daviddobbie/rocketProject2017/Active-Stabilisation-Gyroscope/Gimbal MK4/README.md

# Active Stabilisation Gyroscope Gimbal MK4
This is the fourth iteration of the rocket motor gimbal

[Onshape Document](https://cad.onshape.com/documents/ac475682b0dcfe2c53e7e1ff/v/39afad7ddf3185f5003d1adf/e/2e63972efa3253e1ef49b592)

This design was made to have similar operation to the previous gimbal revisions using the dual ring gyroscopic system. This gimbal design provided the ability to operate rockets using up to a G class rocket motor. This therefore meaning that larger rockets could be launched with this design. This design was made to be integrated into the 1st stage (Booster stage) of the projects 2 stage active to passive rocket system

### Hardware Required

    * HC2422T Servo
    * 1/32inch control rod
    * 4X M3x10mm
    * 2X M3x15mm
    * 4X M3x20mm
    * 2X M3x35mm
