daviddobbie/rocketProject2017/Tech Docs/costchart.md

|Item|Unit Cost (NZD)|QTY|Total Cost (NZD)|
|----|---|---|---|
|Teensy 3.6 Dev Board|57.44|2|114.88|
|RFM96W Radio| 30.56|2|61.12|
|SMA End Launcher Connector|4.46|2|8.92|
|[SiRFstarIV GPS module](http://nz.element14.com/maestro-wireless-solutions/a2200a/gps-module-rom-based-mini-outline/dp/228169401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)|20.20|1|20.20|
|[MPA-154-ANT L1 GPS](http://nz.element14.com/maxtena/mpa-154/ant-l1-gps-passive-embedded-15mm/dp/2281625#anchorTechnicalDOCS)|9.93|3|29.79|
|[RF switch](http://nz.element14.com/skyworks-solutions/as214-92lf/ic-switch-rf-spdt-0-01-3-0ghz/dp/1753767)|2.01|3|2.01|
|[Metal Gear High Voltage Digital Servo ](https://hobbyking.com/en_us/jx-pdi-hv2546mg-metal-gear-high-voltage-digital-park-servo-6-6kg-0-10sec-26-32g.html)|20.16|2|40.32|
|[TG9e Eco Micro Servo 1.5kg](https://hobbyking.com/en_us/turnigytm-tg9e-eco-micro-servo-1-5kg-0-10sec-9g.html?wrh_pdp=3)|2.34|2|4.68|
|[100pF 1206 Capacitor](http://nz.element14.com/walsin/1206n101j500ct/capacitor-mlcc-np0-100pf-50v-1206/dp/2497125)|0.028|10|0.28|
|[10kohm 1206 Resistor](http://nz.element14.com/walsin/wr12x1002ftl/res-thick-film-10k-1-200v-1206/dp/2502605)|0.005|10|0.05|
|[GY-91 IMU breakout](https://www.banggood.com/GY-91-MPU9250-BMP280-10DOF-Acceleration-Gyroscope-Compass-Nine-Shaft-Sensor-Module-p-1129541.html)|11.75|1|11.75|
|SBR3U40P1-7 SMT Schottky Diode|0.715|10|7.15|
|PCB|20.00(est.)|1|20.00|
|Total Cost|||321.15|
