daviddobbie/rocketProject2017/Imu-Demonstration/IMU.pptx

## IMU Development

//TODO: Plan, Actual, Future

## What is an IMU?

- An IMU, also known as an Inertial Measurement Unit, is an electronic component that measures intrinsic properties related to orientation.
- Generates rates of change w.r.t. acceleration, gyroscopic, & magnetic data in the (x,y,z) axes.
- Quaternion mathematics can be applied to produce

## Why do we need an IMU?

## How the IMU integrates into the rocket avionics package

## IMU procurement & selection

- Procurement was performed by

## IMU Software Development Pt. 1

## IMU Software development Pt. 2

## How the IMU software meets performance quality metrics

## How the IMU software meets correctness quality metrics

## Demonstration

- Running on an Arduino board
