daviddobbie/rocketProject2017/Rocket Modelling/readme.md

# Rocket Modelling
## Open Rocket
All the rocket designs were modelled with the OpenRocket software.    
This was done to simulate each designs performance when launched.   
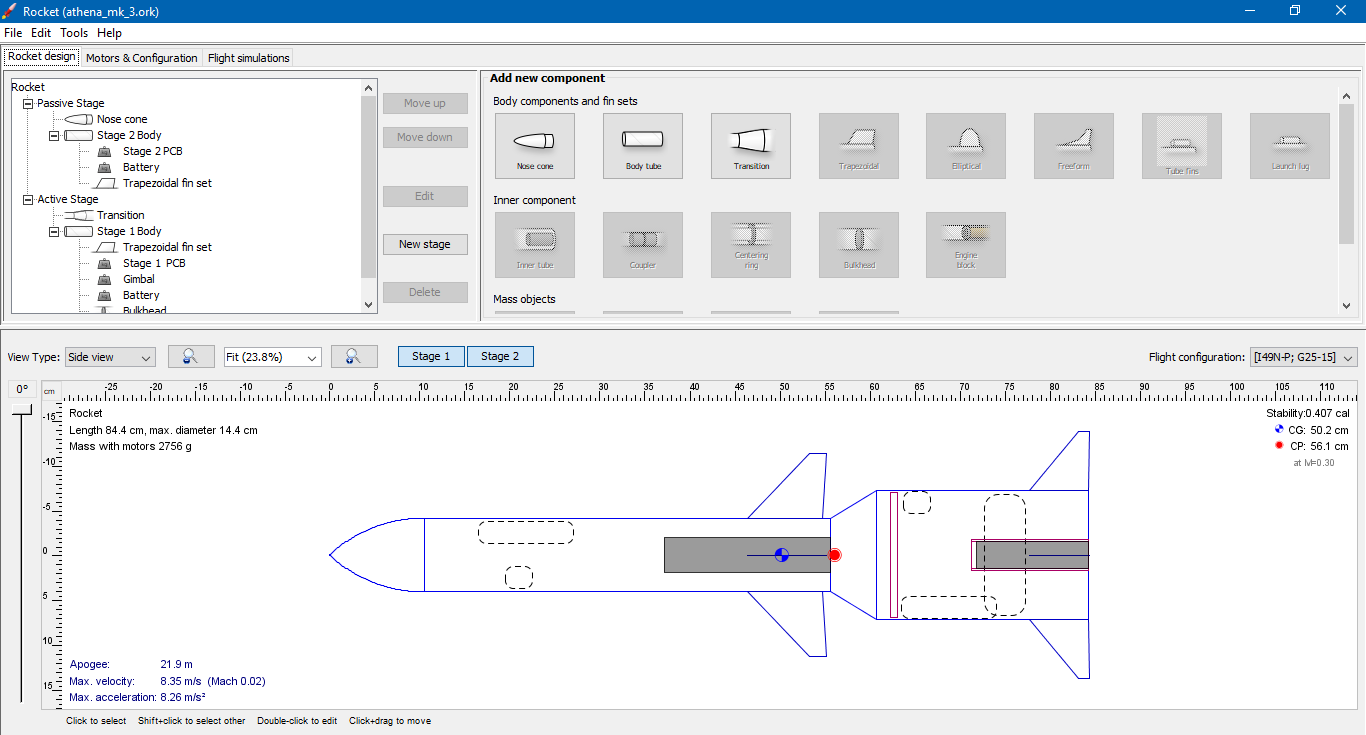
[picture p6: Rocket Modelling/openrocket_demo.PNG]
OpenRocket Interface
