daviddobbie/rocketProject2017/Control-system/active rocket for launch.jpg

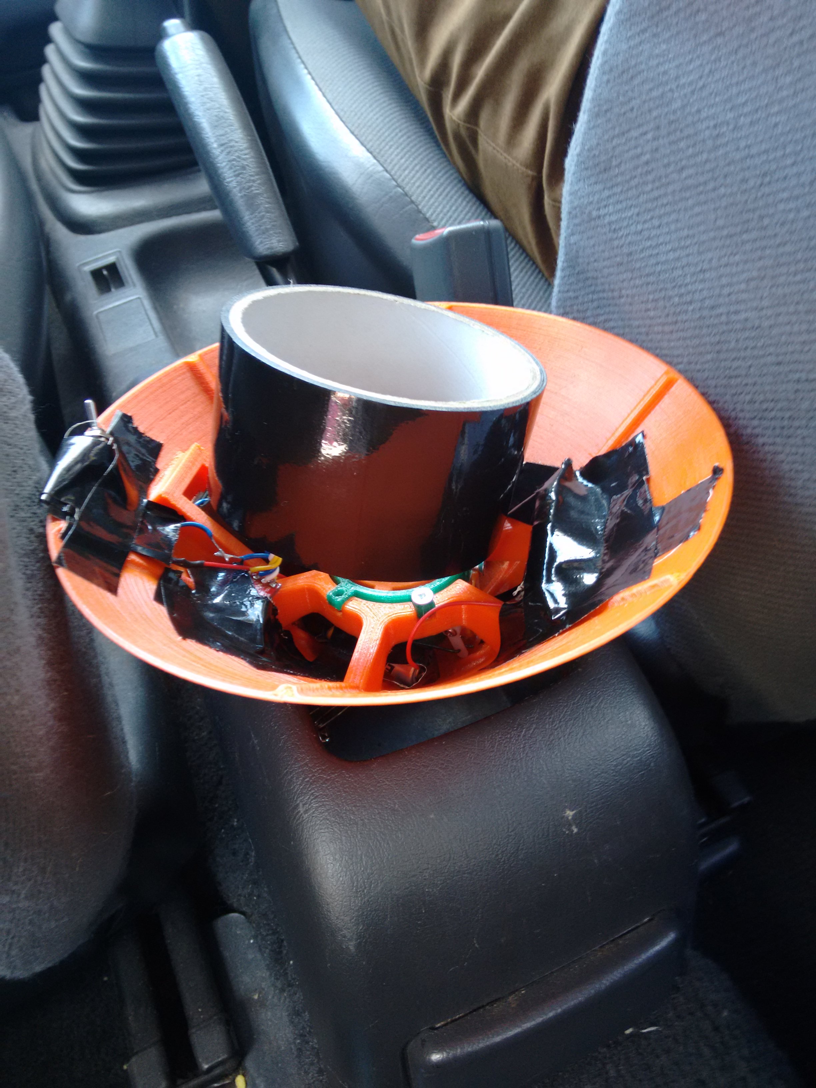
Control-system/active rocket for launch.jpg
