daviddobbie/rocketProject2017/Control-system/matlab output.jpg

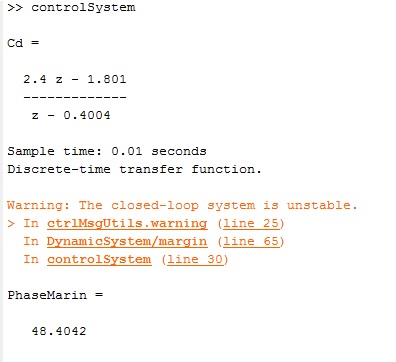
Control-system/matlab output.jpg
