daviddobbie/rocketProject2017/Control-system/system bode plot.jpg

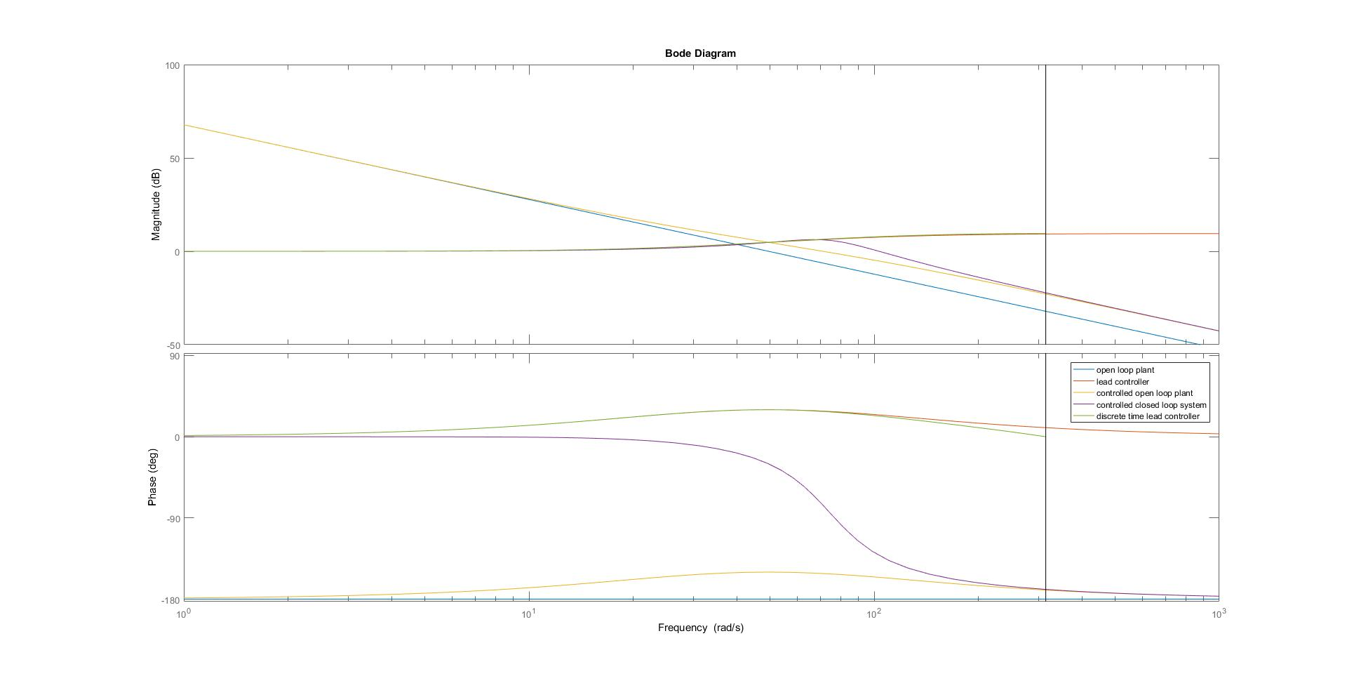
Control-system/system bode plot.jpg
