daviddobbie/rocketProject2017/Control-system/System transfer function derivation.jpg

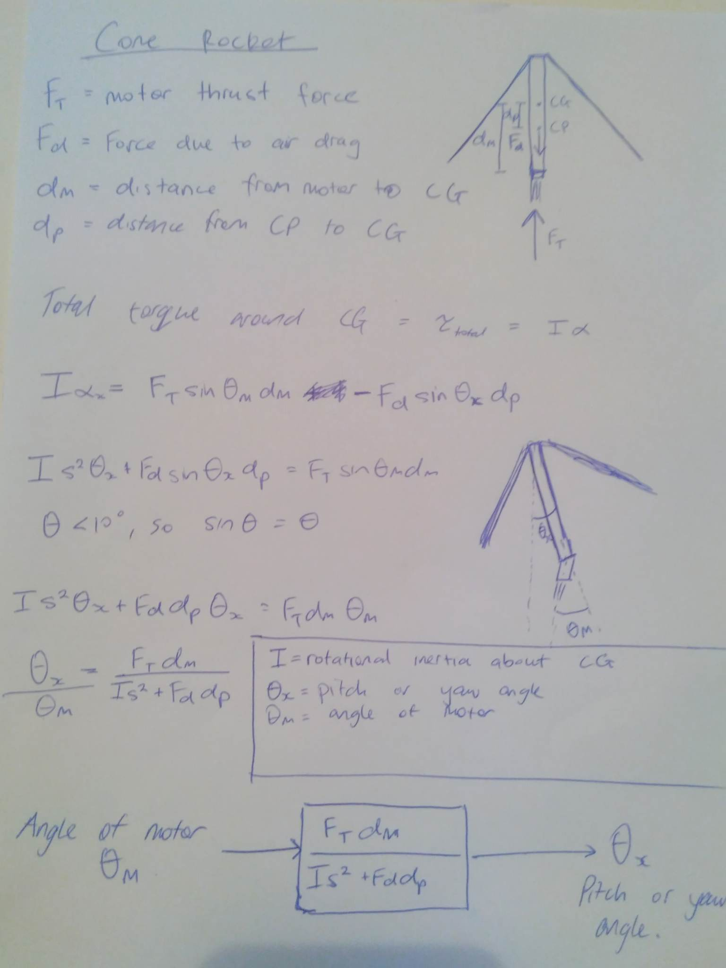
Control-system/System transfer function derivation.jpg
