daviddobbie/rocketProject2017/PCB/Athena_Mk1/Layout.png

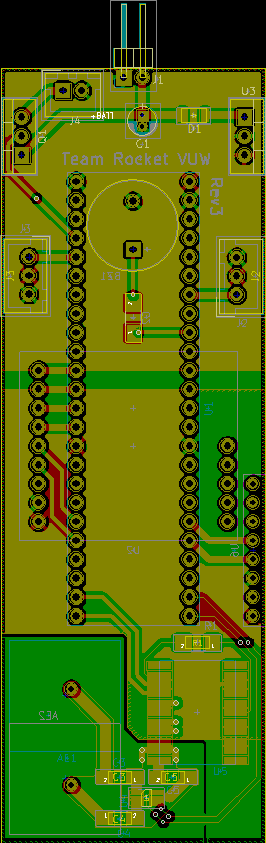
PCB/Athena_Mk1/Layout.png
