daviddobbie/rocketProject2017/PCB/Athena_Mk1/Schematic.png

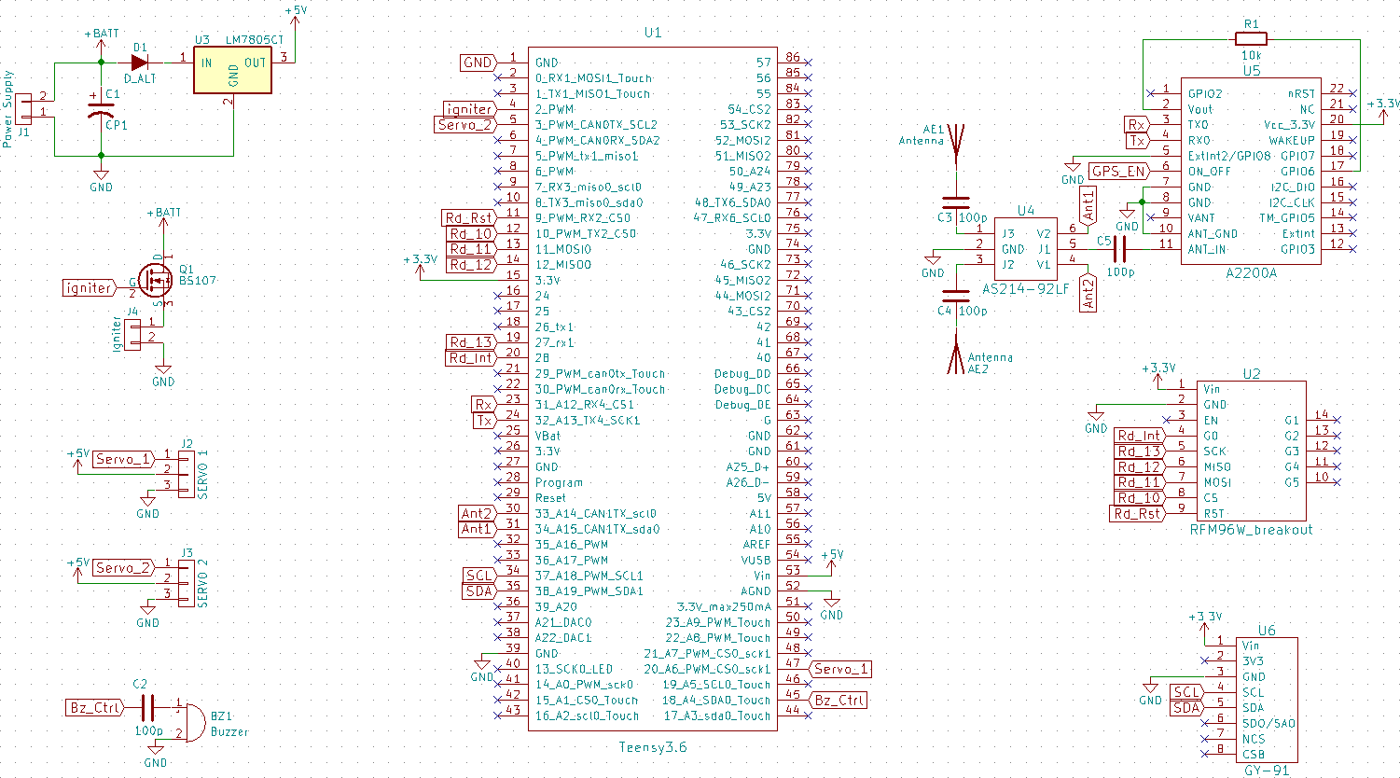
PCB/Athena_Mk1/Schematic.png
