daviddobbie/rocketProject2017/recovery/associated_pictures/settingSpecificCOMport.PNG

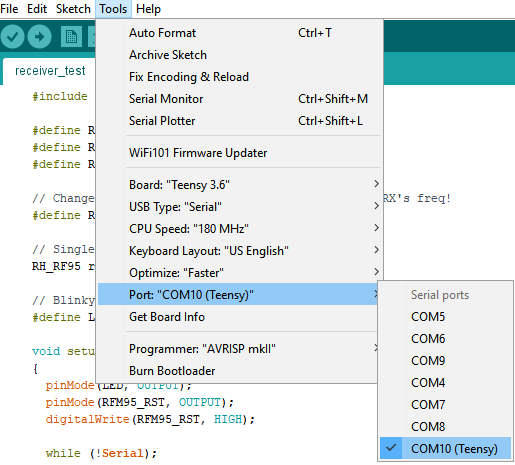
recovery/associated_pictures/settingSpecificCOMport.PNG
