daviddobbie/rocketProject2017/recovery/associated_pictures/SpectrumAnalysis/2-setFrequency.PNG

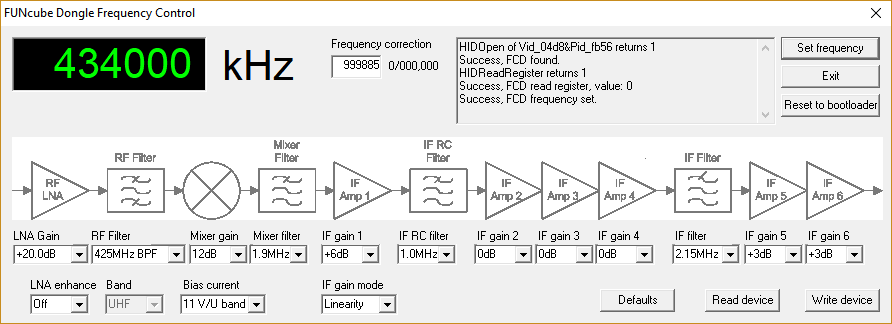
recovery/associated_pictures/SpectrumAnalysis/2-setFrequency.PNG
