daviddobbie/rocketProject2017/recovery/associated_pictures/SpectrumAnalysis/6-continumm.PNG

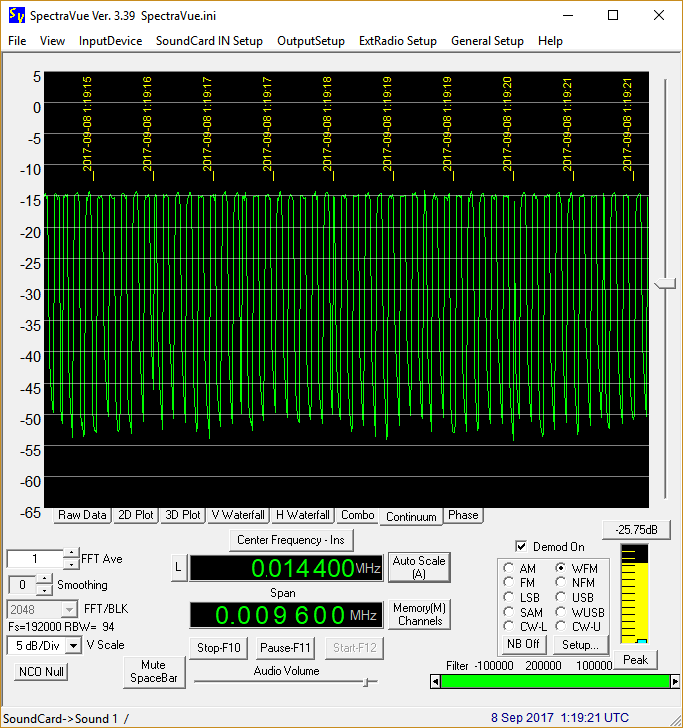
recovery/associated_pictures/SpectrumAnalysis/6-continumm.PNG
