daviddobbie/rocketProject2017/recovery/associated_pictures/SpectrumAnalysis/6-startButton.PNG

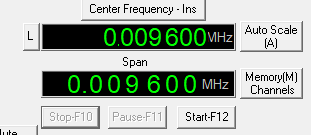
recovery/associated_pictures/SpectrumAnalysis/6-startButton.PNG
