daviddobbie/rocketProject2017/recovery/associated_pictures/SpectrumAnalysis/8-signalExample.PNG

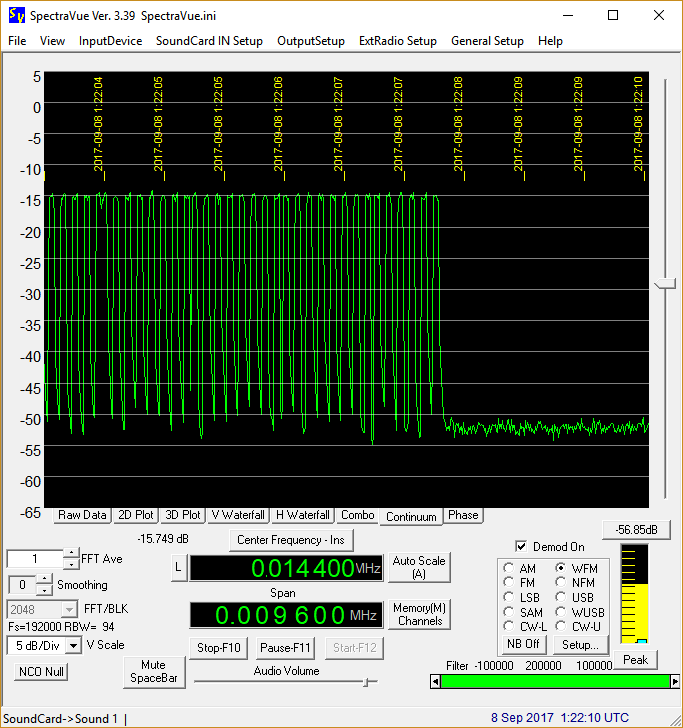
recovery/associated_pictures/SpectrumAnalysis/8-signalExample.PNG
