daviddobbie/rocketProject2017/recovery/radio_system_diagram.PNG

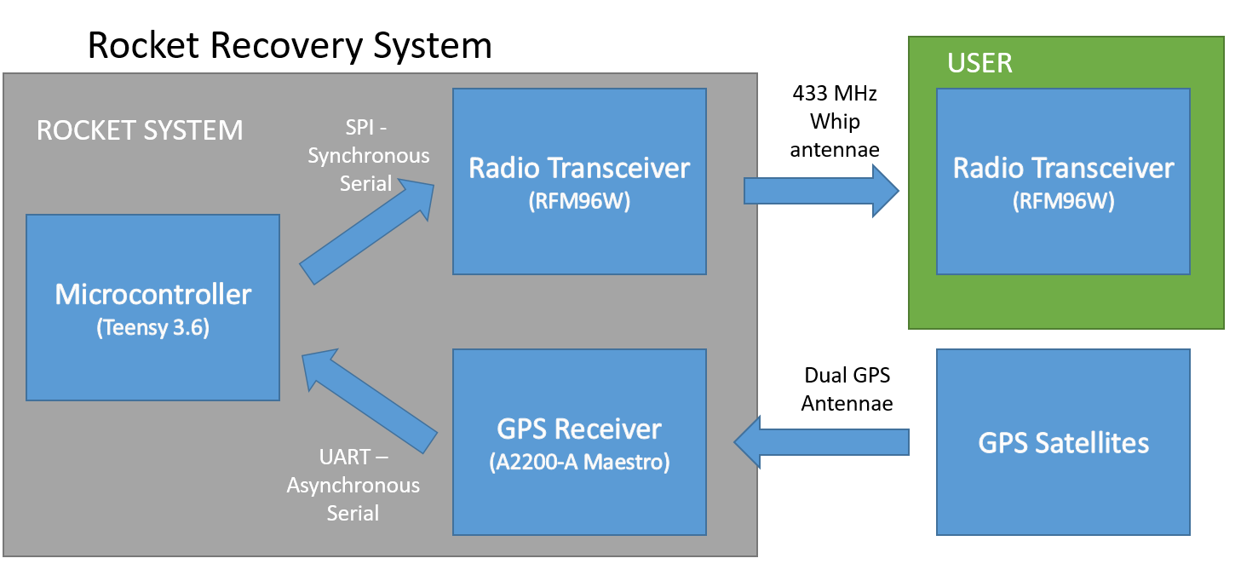
recovery/radio_system_diagram.PNG
