daviddobbie/rocketProject2017/Tech Docs/Parts-Inventory.md

|Item|Qty|Description|
|----|:---:|---|
|Parachute|1|46cm ~ 18inch Diameter parachute|
|Li-ion Battery|1|2S 7.4V 600mAh|
|[Teensy 3.2](https://www.pjrc.com/store/teensy32.html)|1|USB-based microcontoller development system|
|[Teensy 3.6](https://www.pjrc.com/store/teensy36.html)|2|USB-based microcontoller development system|
|[RMF96w](http://www.hoperf.com/upload/rf/RFM95_96_97_98W.pdf)|2|434MHZ radio Transceiver|
|[LD33CV](https://www.sparkfun.com/products/526)|1|Voltage Regulator 3.3V Io 800mA|
|[L7805CV](http://nz.mouser.com/ProductDetail/STMicroelectronics/L7805CV/?qs=9NrABl3fj%2FqplZAHiYUxWg%3D%3D)|4|Linear Voltage Regulator 5.0V 1.0A|
|[Elna DB-5R5D105T](http://www.mouser.com/ProductDetail/Elna/DB-5R5D105T/?qs=r8OyiFxb6Rcu1BWmqcONIQ==)|2|1f 5.5V Supercapacitor|
|[Vinnic L1016](http://www.batteryannex.com/index.php?main_page=product_info&products_id=373)|2|6V Alkaline High Voltage Battery 11A|
|[ESP8266](https://www.sparkfun.com/products/13678)|3|WiFi Module|
|[LM324AN](http://nz.mouser.com/ProductDetail/Fairchild-Semiconductor/LM324AN/?qs=AFLC8Sm4xaWh3GAKvNiiWg%3D%3D)|4|Quad Operational Amp|
|[LM3914N-1](https://www.digikey.co.nz/product-detail/en/texas-instruments/LM3914N-1/LM3914N-1-ND/3701307)|1|IC DRIVER DOT BAR DISPLAY 18-DIP|
|[LM741CN](https://www.digikey.co.nz/product-detail/en/texas-instruments/LM741CN-NOPB/LM741CNNS-NOPB-ND/6322)|1|Op Amp|
|[L3G4200D](https://www.sparkfun.com/products/10612)|1|low-power three-axis angular rate sensor (gyro)|
|[WeMos Micro SD card Shield](https://www.wemos.cc/product/micro-sd-card-shield.html)|1|Micro SD card Shield|
|[D1 Mini](https://www.wemos.cc/product/d1-mini.html)|1| wifi board based on ESP-8266EX|
|[Si4944DY](http://pdf.datasheetcatalog.com/datasheet/vishay/72512.pdf)|2|Dual N-Channel 30-V (D-S) MOSFET (not 100% sure)|
|[SparkFun microSD Transflash Breakout](https://www.sparkfun.com/products/544)|2|microSD Breakout board|
|[SparkFun Venus GPS](https://www.sparkfun.com/products/11058)|1|GPS with SMA Connector|
|[RFM22B-S (link is 915MHz version)](https://www.sparkfun.com/products/12030)|2|434MHz Transceiver Module|
|[10 Segment LED Bar Graph](https://www.sparkfun.com/products/9935)|1|10 Segment LED Bar Graph|
|[HKM-282A](https://hobbyking.com/en_us/hk-282a-single-screw-ultra-micro-servo-2g-0-2kg-0-08sec.html?___store=en_us)|4|Micro 1S LiPo driven servo|
|[Antenna GPS Embedded SMA](https://www.sparkfun.com/products/177)|1|Basic unpackaged antenna with LNA|
|Sarantel antenna|1|Unidentified|
|[FCD Pro V1.1](http://www.funcubedongle.com/MyImages/FCDAnIntroduction.pdf)|1|FunCude USB dongle|
|Assorted Potentiometers|4|Unidentified|
|Dip Switch|1|2 Position|
|Assorted LED|3|LED|
|[Snap Action Switch](https://www.sparkfun.com/products/98)|1|Whisker Switches - Very sensitive lever switch|
|Slide Switch|1|Unidentified|
|GPS Module|1|Unidentified, has Antenna|
|SanDisk Micro SD card|1|class 10, with SD card adapter|
|[GY-91 IMU breakout](https://www.banggood.com/GY-91-MPU9250-BMP280-10DOF-Acceleration-Gyroscope-Compass-Nine-Shaft-Sensor-Module-p-1129541.html)|1|IMU|
|[Metal Gear High Voltage Digital Servo ](https://hobbyking.com/en_us/jx-pdi-hv2546mg-metal-gear-high-voltage-digital-park-servo-6-6kg-0-10sec-26-32g.html)|2|High voltage servo|
|EMAX ES08A Servo|1|8.5g servo|
