daviddobbie/rocketProject2017/Active-Stabilisation-Gyroscope/Gimbal MK4/Outer Gyro Mount.stl

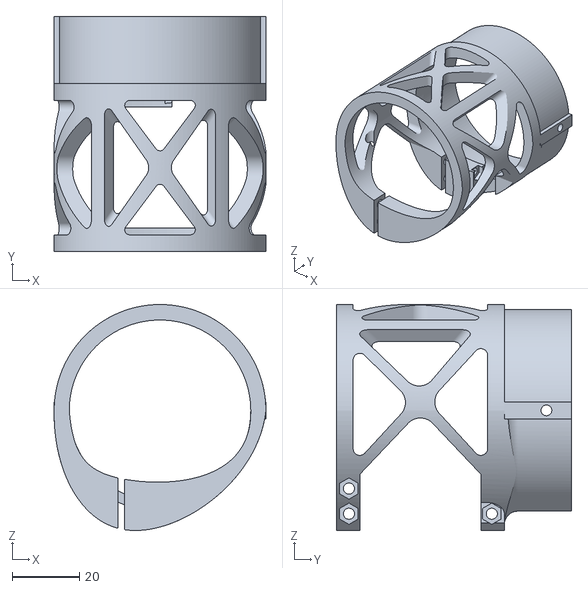
[picture p19: CAD file, 2017-10-17]
Active-Stabilisation-Gyroscope/Gimbal MK4/Outer Gyro Mount.stl
63.0 x 70.0 x 67.2
