daviddobbie/rocketProject2017/Rocket CAD/Athena Mk 3/Athena Mk 3.0 - PCBr3 Model.stl

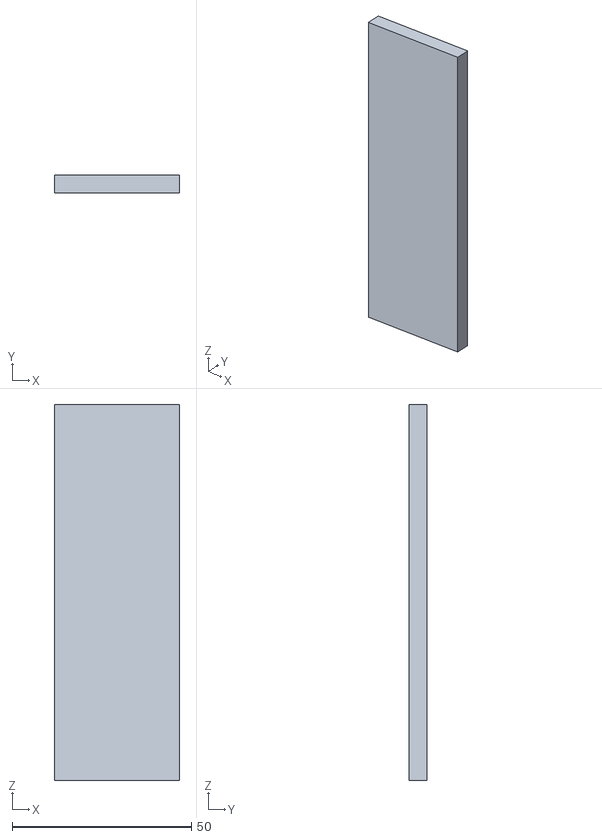
[picture p20: CAD file, 2017-10-20]
Rocket CAD/Athena Mk 3/Athena Mk 3.0 - PCBr3 Model.stl
35.0 x 5.00 x 105.0
