daviddobbie/rocketProject2017/Active-Stabilisation-Gyroscope/Gimbal MK4/HC2422T.stl

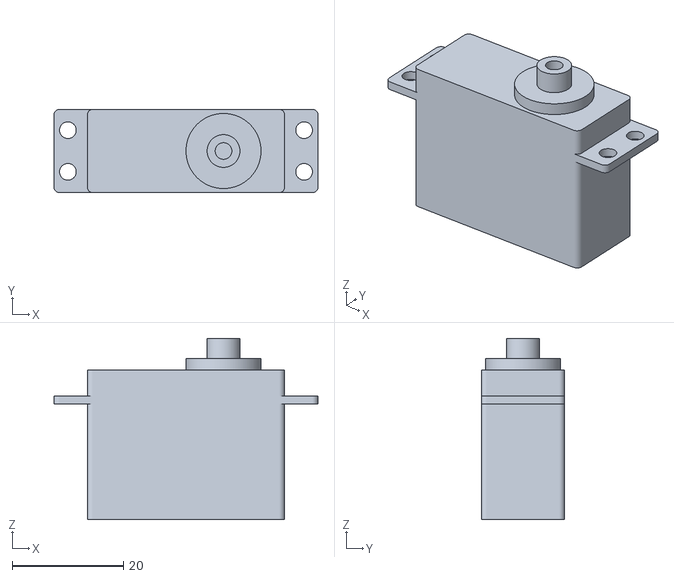
[picture p21: CAD file, 2017-10-16]
Active-Stabilisation-Gyroscope/Gimbal MK4/HC2422T.stl
47.5 x 15.0 x 32.7
