daviddobbie/rocketProject2017/Rocket CAD/Athena Mk 3/Athena Mk 3.0 - I Motor Model.stl

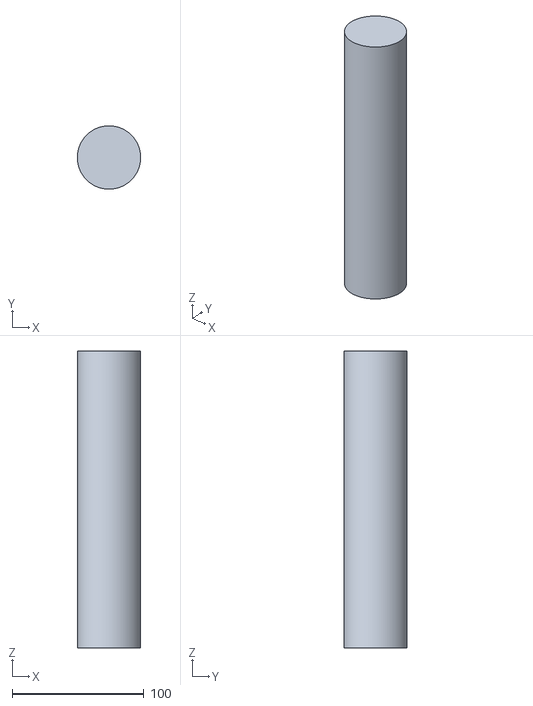
[picture p22: CAD file, 2017-10-20]
Rocket CAD/Athena Mk 3/Athena Mk 3.0 - I Motor Model.stl
48.0 x 48.0 x 225.0
