daviddobbie/rocketProject2017/Active-Stabilisation-Gyroscope/Gimbal MK4/G125-14A Motor.stl

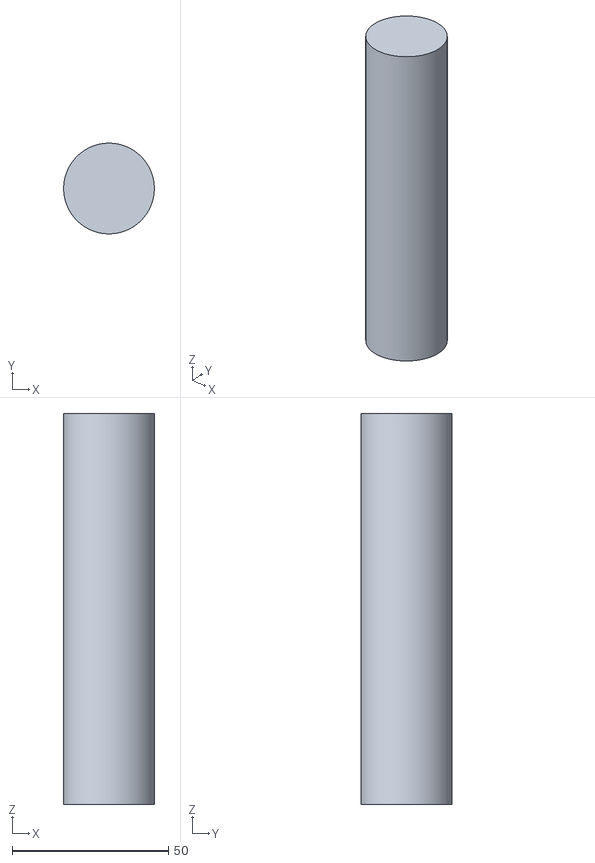
[picture p23: CAD file, 2017-10-16]
Active-Stabilisation-Gyroscope/Gimbal MK4/G125-14A Motor.stl
29.0 x 29.0 x 125.0
