daviddobbie/rocketProject2017/Rocket CAD/Athena Mk 3/Athena Mk 3.0 - Second Stage Nosecone.stl

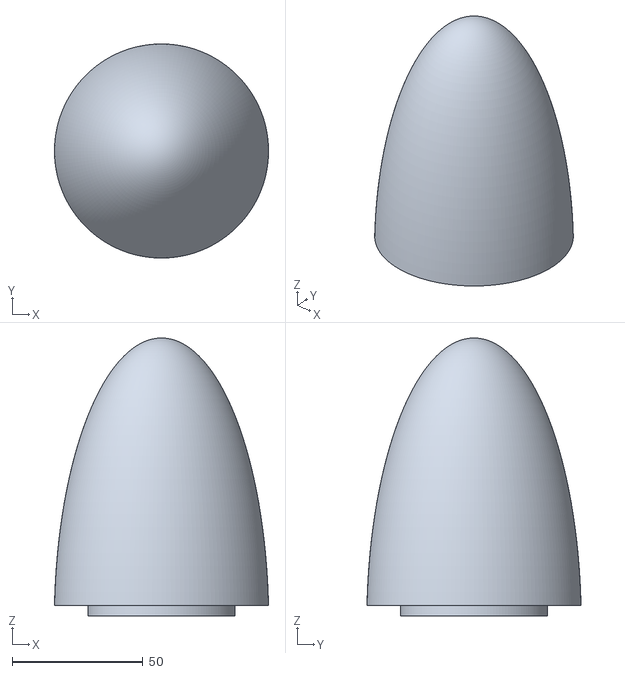
[picture p24: CAD file, 2017-10-18]
Rocket CAD/Athena Mk 3/Athena Mk 3.0 - Second Stage Nosecone.stl
82.0 x 82.0 x 106.4
