daviddobbie/rocketProject2017/Active-Stabilisation-Gyroscope/Gimbal MK4/Inner Gyro Ring.stl

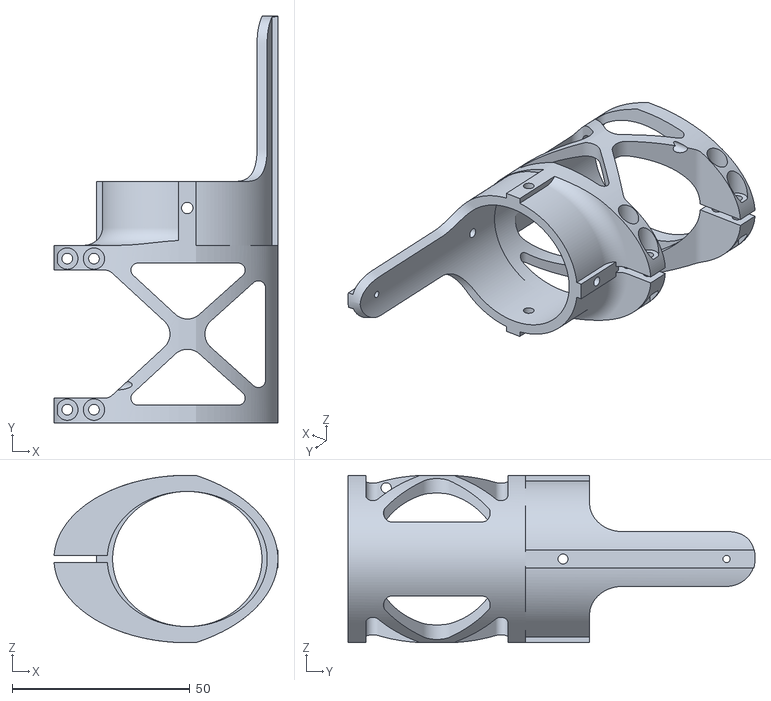
[picture p25: CAD file, 2017-10-16]
Active-Stabilisation-Gyroscope/Gimbal MK4/Inner Gyro Ring.stl
63.0 x 114.5 x 47.0
