daviddobbie/rocketProject2017/Rocket CAD/Athena Mk 3/Athena Mk 3.0 - Second Stage Body.stl

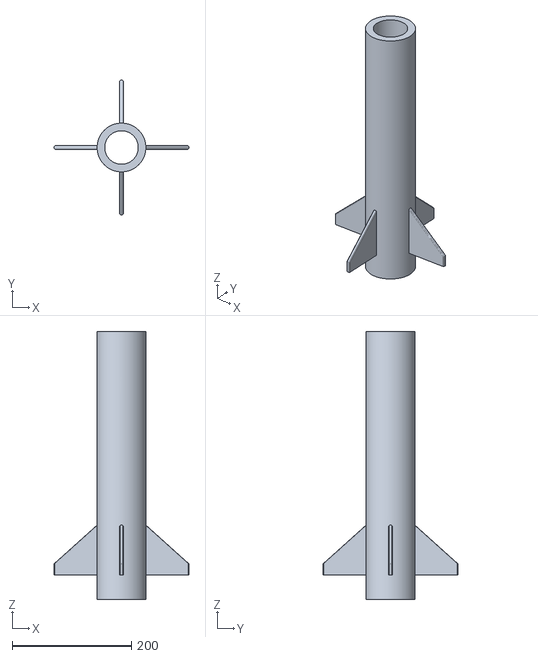
[picture p26: CAD file, 2017-10-18]
Rocket CAD/Athena Mk 3/Athena Mk 3.0 - Second Stage Body.stl
226.2 x 226.2 x 450.0
