daviddobbie/rocketProject2017/Active-Stabilisation-Gyroscope/Gimbal MK4/D Motor 'Booster Seat'.stl

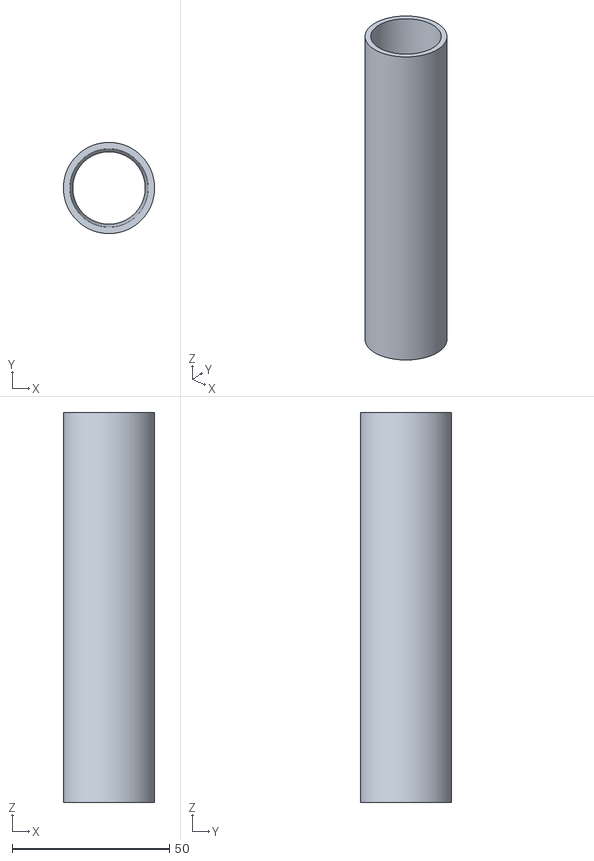
[picture p27: CAD file, 2017-10-16]
Active-Stabilisation-Gyroscope/Gimbal MK4/D Motor 'Booster Seat'.stl
29.0 x 29.0 x 124.0
