daviddobbie/rocketProject2017/Rocket CAD/Athena Mk 3/Athena Mk 3.0 - Gimbal to Body Mount.stl

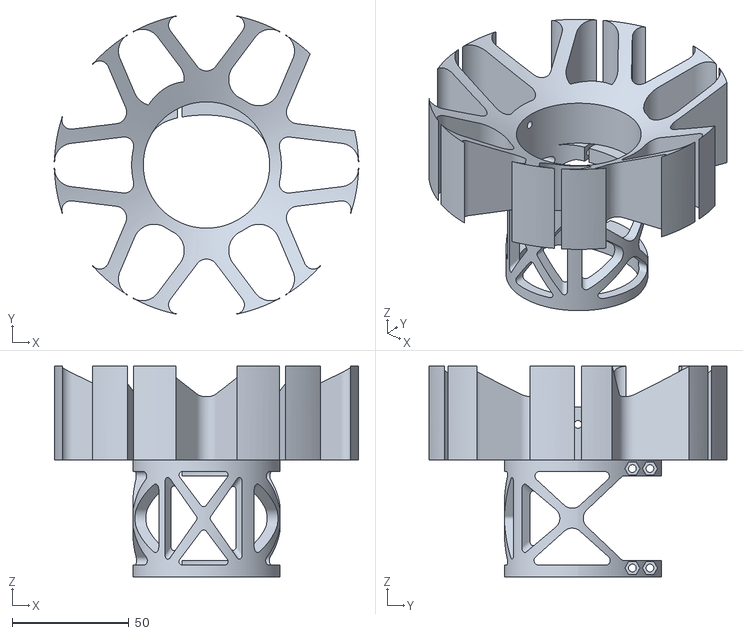
[picture p28: CAD file, 2017-10-18]
Rocket CAD/Athena Mk 3/Athena Mk 3.0 - Gimbal to Body Mount.stl
130.0 x 127.4 x 90.0
