daviddobbie/rocketProject2017/Active-Stabilisation-Gyroscope/Gimbal MK4/Motor Mount Ring.stl

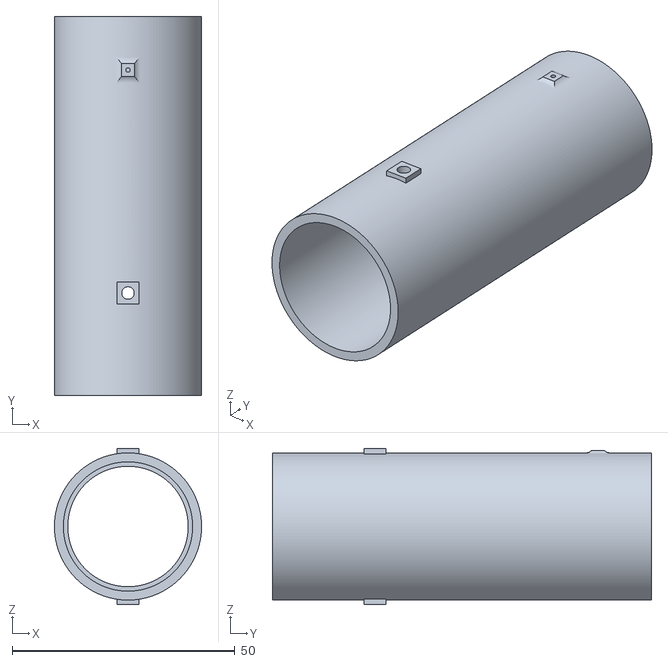
[picture p29: CAD file, 2017-10-16]
Active-Stabilisation-Gyroscope/Gimbal MK4/Motor Mount Ring.stl
33.0 x 85.0 x 35.0
