daviddobbie/rocketProject2017/Active-Stabilisation-Gyroscope/Gimbal MK4/C Motor 'Booster Seat'.stl

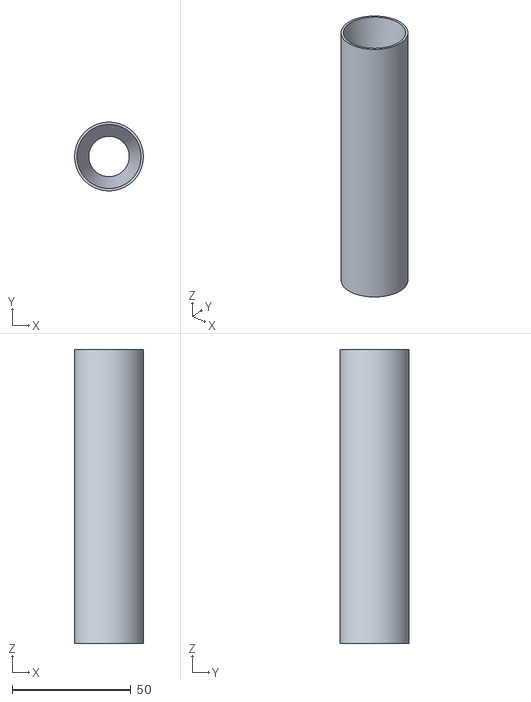
[picture p30: CAD file, 2017-10-16]
Active-Stabilisation-Gyroscope/Gimbal MK4/C Motor 'Booster Seat'.stl
29.0 x 29.0 x 124.0
