daviddobbie/rocketProject2017/Active-Stabilisation-Gyroscope/Gimbal MK1/Motor Mount_Inner Ring.stl

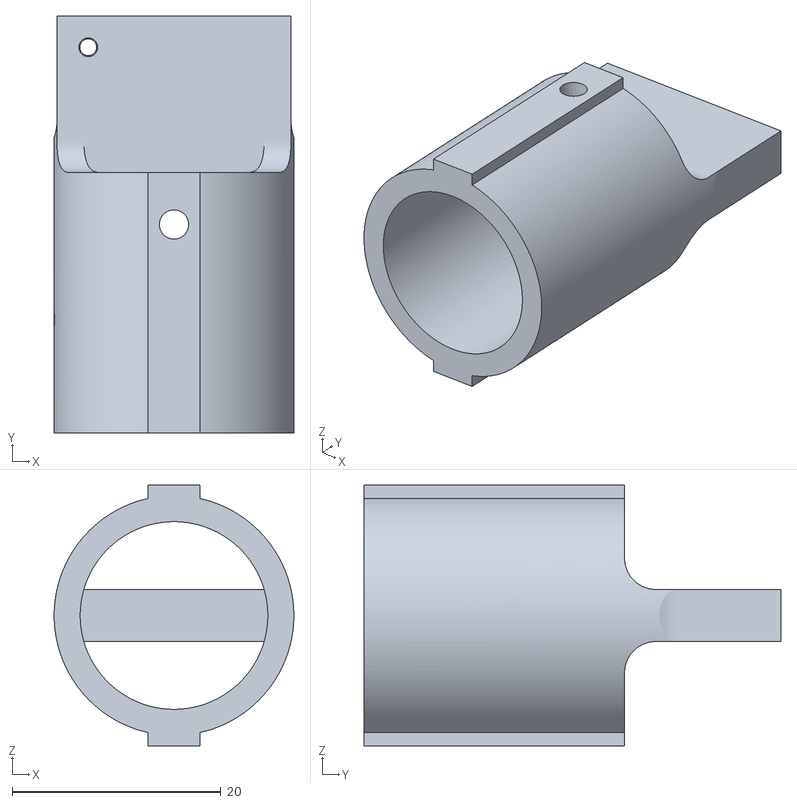
[picture p31: CAD file, 2017-10-16, an earlier design]
Active-Stabilisation-Gyroscope/Gimbal MK1/Motor Mount_Inner Ring.stl
23.0 x 40.0 x 25.0
