daviddobbie/rocketProject2017/Active-Stabilisation-Gyroscope/Gimbal MK2/Outer Gyro Mount.stl

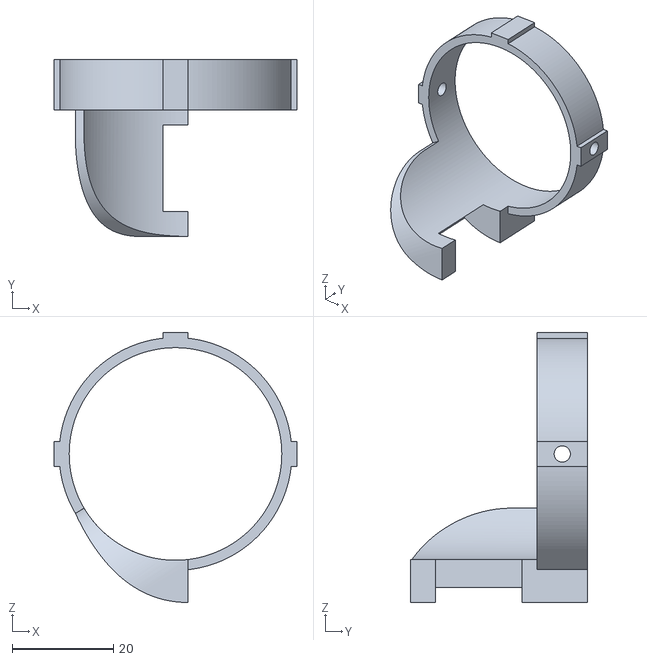
[picture p32: CAD file, 2017-10-16, an earlier design]
Active-Stabilisation-Gyroscope/Gimbal MK2/Outer Gyro Mount.stl
48.0 x 35.0 x 53.4
