daviddobbie/rocketProject2017/Active-Stabilisation-Gyroscope/Gimbal MK3/Outer Gyro Mount.stl

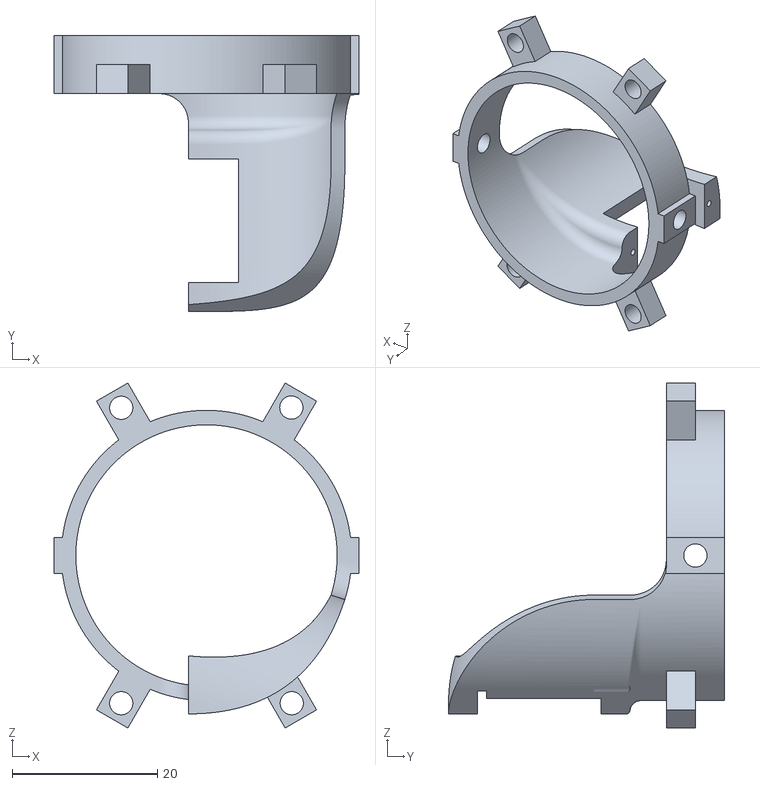
[picture p33: CAD file, 2017-10-16, an earlier design]
Active-Stabilisation-Gyroscope/Gimbal MK3/Outer Gyro Mount.stl
42.0 x 38.0 x 47.5
