daviddobbie/rocketProject2017/Rocket CAD/Athena Mk 1/Athena Mk 1- Motor Mount.stl

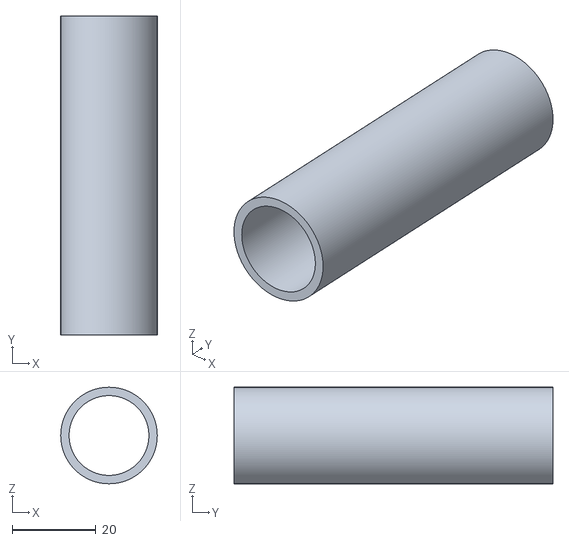
[picture p34: CAD file, 2017-10-18, an earlier design]
Rocket CAD/Athena Mk 1/Athena Mk 1- Motor Mount.stl
23.0 x 76.0 x 23.0
