daviddobbie/rocketProject2017/Rocket CAD/Athena Mk 2/Athena Mk 2.1 - Final Cone.stl

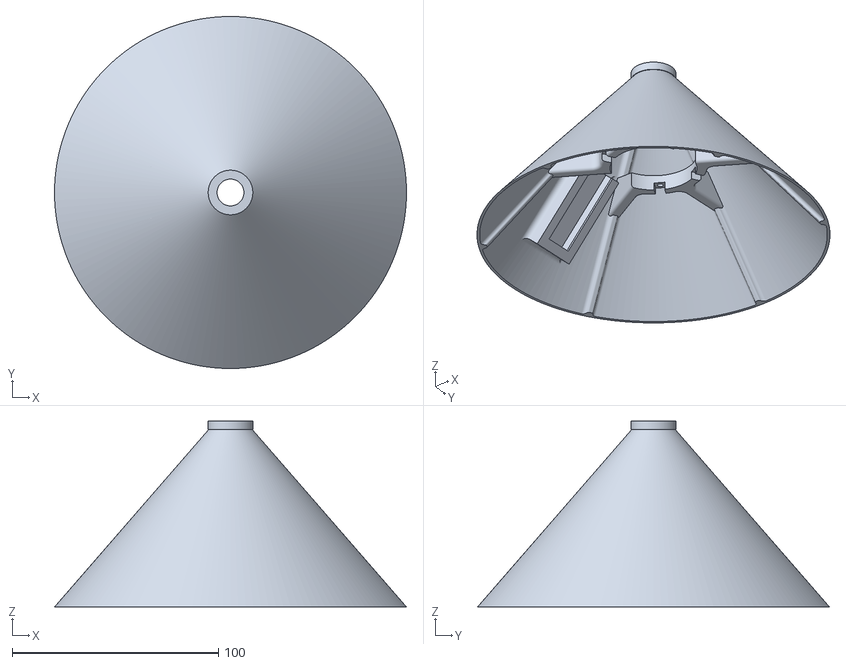
[picture p35: CAD file, 2017-10-18, an earlier design]
Rocket CAD/Athena Mk 2/Athena Mk 2.1 - Final Cone.stl
170.5 x 170.5 x 90.0
