daviddobbie/rocketProject2017/Active-Stabilisation-Gyroscope/Gimbal MK1/C6-5 Motor.stl

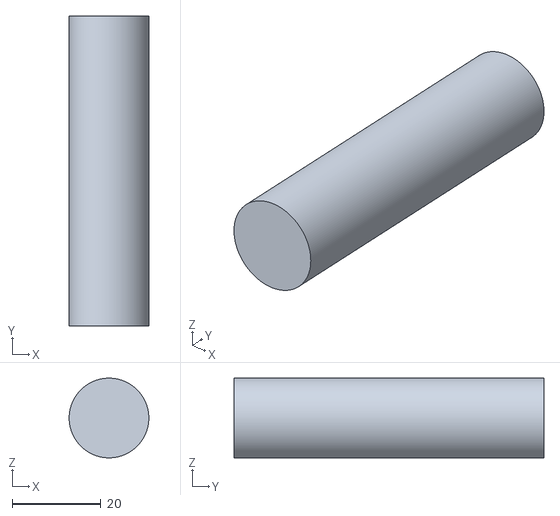
[picture p36: CAD file, 2017-10-16, an earlier design]
Active-Stabilisation-Gyroscope/Gimbal MK1/C6-5 Motor.stl
18.0 x 70.0 x 18.0
