daviddobbie/rocketProject2017/(list of files, cad)

Other CAD files:
Active-Stabilisation-Gyroscope/Gimbal MK1/Gyro Mount.stl
Active-Stabilisation-Gyroscope/Gimbal MK1/HKM-282A.stl
Active-Stabilisation-Gyroscope/Gimbal MK1/Outer Gyro Ring.stl
Active-Stabilisation-Gyroscope/Gimbal MK2/Inner Gyro Ring.stl
Active-Stabilisation-Gyroscope/Gimbal MK2/Motor Mount Ring.stl
Active-Stabilisation-Gyroscope/Gimbal MK3/Inner Gyro Ring.stl
Active-Stabilisation-Gyroscope/Gimbal MK3/Motor Mount Ring.stl
Rocket CAD/Athena Mk 1/Athena Mk 1 - Body.stl
Rocket CAD/Athena Mk 1/Athena Mk 1 - Centering Ring.stl
Rocket CAD/Athena Mk 1/Athena Mk 1 - Nose Cone.stl
Rocket CAD/Athena Mk 1/Athena Mk 1- Engine Block.stl
Rocket CAD/Athena Mk 2/Athena Mk 2.0 - Final Cone.stl
Rocket CAD/Athena Mk 2/Athena Mk 2.0 - Initial Cone.stl
