daviddobbie/rocketProject2017/recovery/associated_pictures/SpectrumAnalysis/4-setupSoundCard.PNG

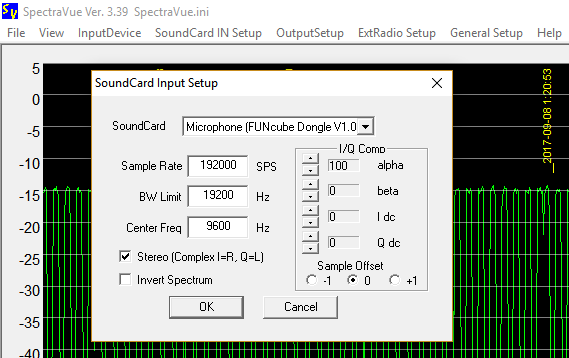
recovery/associated_pictures/SpectrumAnalysis/4-setupSoundCard.PNG
