daviddobbie/rocketProject2017/recovery/module_testing_code/readme.txt

Contains the testing code for the GPS and the radio system. This is to help with further development of the system.
