daviddobbie/rocketProject2017/recovery/module_testing_code/GPS_data test/GPSdata_map2.PNG

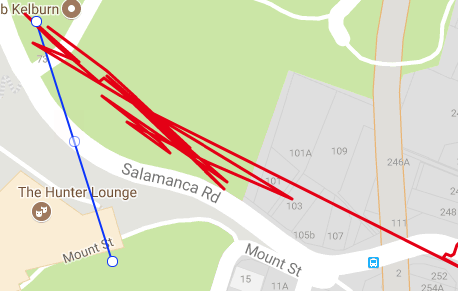
recovery/module_testing_code/GPS_data test/GPSdata_map2.PNG
