daviddobbie/rocketProject2017/recovery/home_base/home_base_rev3/home_base_rev3.ino

    // Arduino9x_RX
    // -*- mode: C++ -*-
    // Example sketch showing how to create a simple messaging client (receiver)
    // with the RH_RF95 class. RH_RF95 class does not provide for addressing or
    // reliability, so you should only use RH_RF95 if you do not need the higher
    // level messaging abilities.
    // It is designed to work with the other example Arduino9x_TX
     
    #include <SPI.h>
    #include <TimeLib.h>

    
    #include <RH_RF95.h>
     
    #define RFM95_CS 10
    #define RFM95_RST 9
    #define RFM95_INT 28
     
    // Change to 434.0 or other frequency, must match RX's freq!
    #define RF95_FREQ 434.0
     
    // Singleton instance of the radio driver
    RH_RF95 rf95(RFM95_CS, RFM95_INT);
     
    // Blinky on receipt
    #define LED 13

    boolean debug = false;
     
    void setup() 
    {
      pinMode(LED, OUTPUT);     
      pinMode(RFM95_RST, OUTPUT);
      digitalWrite(RFM95_RST, HIGH);
     
      while (!Serial);
      Serial.begin(9600);
      delay(100);
     
      Serial.println("Arduino LoRa RX Test!");
      
      // manual reset
      digitalWrite(RFM95_RST, LOW);
      delay(10);
      digitalWrite(RFM95_RST, HIGH);
      delay(10);
     
      while (!rf95.init()) {
        Serial.println("LoRa radio init failed");
        while (1);
      }
      Serial.println("LoRa radio init OK!");
     
      // Defaults after init are 434.0MHz, modulation GFSK_Rb250Fd250, +13dbM
      if (!rf95.setFrequency(RF95_FREQ)) {
        Serial.println("setFrequency failed");
        while (1);
      }
      Serial.print("Set Freq to: "); Serial.println(RF95_FREQ);


      Serial.println("CSV FORMAT: LONGITUDE, LATITUDE, GPS TIME, GPS CHARS PROCESSED, BASE MODULE TIME ELAPSED, RADIO SIGNAL STRENGTH");
      // Defaults after init are 434.0MHz, 13dBm, Bw = 125 kHz, Cr = 4/5, Sf = 128chips/symbol, CRC on
     
      // The default transmitter power is 13dBm, using PA_BOOST.
      // If you are using RFM95/96/97/98 modules which uses the PA_BOOST transmitter pin, then 
      // you can set transmitter powers from 5 to 23 dBm:
      rf95.setTxPower(23, false);
    }
     
    void loop()
    {
      if (rf95.available())
      {
        // Should be a message for us now   
        uint8_t buf[RH_RF95_MAX_MESSAGE_LEN];
        uint8_t len = sizeof(buf);
        
        if (rf95.recv(buf, &len))
        {
          digitalWrite(LED, HIGH);
          if(debug) RH_RF95::printBuffer("Received: ", buf, len);
          Serial.print((char*)buf);
          Serial.print(", " + currentTime() + ", "); //posts receiver's time stamp
          Serial.println(+rf95.lastRssi(), DEC);
          
          // Send a reply
          digitalWrite(LED, LOW);
        }
        else
        {
          Serial.println("Receive failed");
        }
      }
    }
String currentTime(){
   String t;
   t += hour();
   t += printDigits(minute());
   t += printDigits(second());
   return t;
}
/* makes the time on the Teensy printable*/
String printDigits(int digits){ // taken from example teensy time
  String str = ":";
  if(digits < 10)
    str += "0";
  str += digits;
  return str;
}
