daviddobbie/rocketProject2017/(commit log)

2017-06-04 Initial recovery commit
    [teensy_schematic.sch]
2017-06-05 buzzer altered
    slightly altered buzzer file
    [recovery.ino]
2017-06-15 Create IMU demonstration
2017-06-16 Captured schematic of PCB including Teensy 3.6, Venus GPS, RFM96W, buzzer & power plug
    [Athena_PCB_Mk1.sch]
2017-06-16 small update to tie RFM96W RESET pin to 3.3V
    [Athena_PCB_Mk1.sch]
2017-06-17 First set of basic gyro movement code
2017-06-17 Include WebGL cube demonstration to visually represent IMU data
2017-06-17 Add extra servo movement
2017-06-18 folder for rocket PCBs
2017-06-18 EESchema Schematic
    [Athena_Mk1.sch]
2017-06-18 First attempt at positional IMU data using quaternions
2017-06-18 IMU powerpoint presentation complete
2017-06-18 Replace Athena_Mk1.sch
    [Athena_Mk1.sch]
2017-06-18 Final commit for Arduino. Will now try to use a teensy.
2017-06-18 Switch from AJAX requests to socket.io to improve webserver throughput
2017-06-25 Work so far, includes custom schematic libraries for RFM96W and Venus GPS, and custom footprints for teensy 3.6 and RFM96W
2017-07-18 Updated KiCad files. Layout complete, includes gerbers for fab.
2017-07-19 upload schematic screenshot
2017-07-19 updated gerbers, some adjusted footprints
2017-07-30 Rocket transmitter calibrated to work
    The transmitter pushes out a placeholder GPS coordinates message. We can
    use the receiver code for the base station to receive the messahe. It
    works for a very close range system between the radios.
2017-08-08 sd card read and time tracking finished
    Added a time tracker and sd card reading onto the radio system. The
    receiving radio is able to pick up signals from the assembled radio
    module. Needs an antenna and GPS to be fully functional!
2017-09-05 Revision 3 incorporating IMU, GPS, radio, servos and ignition.
2017-09-05 Replace Schematic.png
2017-09-07 Code to control the servo position based on IMU data
    Comnbined IMU data reading code and Servo control code
2017-09-12 started GPS module
    GPS module is located in a separate file to simplify experimentation.
    Attempted to use the Venus GPS to experiment with i2c communication that
    the onboard GPS uses. However, the firmware on the board doesn't support
    it. There is no easily accessible new firmware without directly querying
    the GPS developers.
    Used a serial communication system for pins 7 and 8, acheived NMEA
    parsing, no lock with any satellites acheived.
    [gps_experiment.ino, recovery.ino]
2017-09-26 implements discrete time lead controller. Sample time set at 10ms(100Hz)
2017-09-27 IMU controls servos working
2017-10-03 gps system is functional
    Been able to parse the data coming out of the GPS module and validating
    a lock (thru RF switch).
    Also indicates the discrete antenna used with the Venus is defective.
    GPS operates (with I2C DIO and I2C CLK pulled high) at 4800 baud rate.
    Hardware defined Serial4 for the Teensy was used.
2017-10-03 GPS system in recovery code
    Integrated recovery code with the new GPS functionality from
    gps_experimen.ino.
    Valid for PCB revision 3.
    The time delay between each radio pulse has been removed, allowing for
    continuous transmission.
    Top antenna is confirmed operational, bottom antenna not yet. Switching
    functionality has not been implemented into the system.
    Also removes dummy fucntions that were from the first start off since
    they are no longer representative of the program.
    [gps_experiment.ino, recovery.ino]
2017-10-09 Control Validations Beginning
    Produced a quick alteration to the IMU to output CSV compatible data.
    Able to see how the IMU adjusts to change in a comparable fashion.
    Loooking to implement a multi-IMU system so if one dies, another can be
    activated.
2017-10-10 Updates to IMU data, quick library comment
    Added data for the servos and the IMU with a rotational environment -
    able to see the behaviour acting on it and quanitatively say what is
    happening in the system. Tyaan in the previous commit has recalibrated
    the control system and adapted the .csv format output on the serial
    line.
    Physically, the Teensy 3.2 has new breakouts so IMU boards and servos
    can be replaced at the rocket launch site. Mainainability and robustness
    has increased. Last things to do is to ensure the power source is
    consistently on and to indicate that the system is about to launch -
    i.e. LED after period of waiting time.
    [controlCode.ino]
2017-10-11 launch LED added
2017-10-12 removed launch LED
2017-10-14 start integrating radio and IMU system
    Started trying to integrate the two systems. Have fallen into problems
    with the I2C communication bus between the IMU and the Teensy
    microcontroller. There must be some blocking or inadequately enabled
    mode on the IMU unit (purple gy-91 currently being used).
    [controlCode.ino]
2017-10-15 Added directory for MK1 gimbal CAD components
2017-10-15 Added MK1 Motor model
    [C6-5 Motor.stl]
2017-10-15 Added MK1 Gyro mount model
    [Gyro Mount.stl]
2017-10-15 Added MK1 servo model
    [HKM-282A.stl]
2017-10-15 Added MK1 Motor Mount model
    [Motor Mount_Inner Ring.stl]
2017-10-15 Added MK1 Outer Ring model
    [Outer Gyro Ring.stl]
2017-10-15 First iteration of gimbal CAD for in rocket use
2017-10-15 Outer Gyro mount for initial gimbaled rocket implementation
    [Outer Gyro Mount.stl]
2017-10-15 Motor Mount Ring for initial gimbaled rocket implementation
    [Motor Mount Ring.stl]
2017-10-15 Inner Gyro Ring for initial gimbaled rocket implementation
    [Inner Gyro Ring.stl]
2017-10-15 Inner Gyro Ring for optimized gimbal configuration
    [Inner Gyro Ring.stl]
2017-10-15 motor mount for optimized gimbal configuration
    [Motor Mount Ring.stl]
2017-10-15 Outer Gyro mount for optimized gimbal configuration
    [Outer Gyro Mount.stl]
2017-10-15 Added mounting points for the gimbal
    [Outer Gyro Mount.stl]
2017-10-15 Added servo wire clearance
    [Inner Gyro Ring.stl]
2017-10-15 Gimbal for use in a rocket using either a G,D or C motor
2017-10-15 Outer Gyro mount for G motor Gimbal
    [Outer Gyro Mount.stl]
2017-10-15 Motor mount for G motor Gimbal
    [Motor Mount Ring.stl]
2017-10-15 inner gyro ring for G motor Gimbal
    [Inner Gyro Ring.stl]
2017-10-15 servo model used in the G motor Gimbal
    [HC2422T.stl]
2017-10-15 D motor adapter for G motor Gimbal
    [D Motor 'Booster Seat'.stl]
2017-10-15 C motor adapter for G motor Gimbal
    [C Motor 'Booster Seat'.stl]
2017-10-15 motor model used for G motor Gimbal
    [G125-14A Motor.stl]
2017-10-15 removed mounting points, servo mounting hole adjusted
    [Outer Gyro Mount.stl]
2017-10-15 servo mounting hole adjusted
2017-10-17 Changes made to the gyro holder ring to insure the servo has full clearance
    [Outer Gyro Mount.stl]
2017-10-17 Renamed files and added readme
    The files in the recovery system have been restructed to allow for
    simple and easy uploading of the radio code onto either a revision 2 or
    revision 3 of the PCb system. Should make it more easier to for outside
    users.
2017-10-17 Switiching Antennae
    Added and confirming switching GPS antennae is functional. Works by
    changing the antenna on every iteration of the loop. Has not been tested
    in a difficult environment yet.
2017-10-18 Upload New File
    [Athena Mk 1 - Body.stl]
